UCSD-Quadcopter-Class/quad-hardware-batman/quadcopter.brd

## EAGLE design quadcopter.brd (2017-05-15)

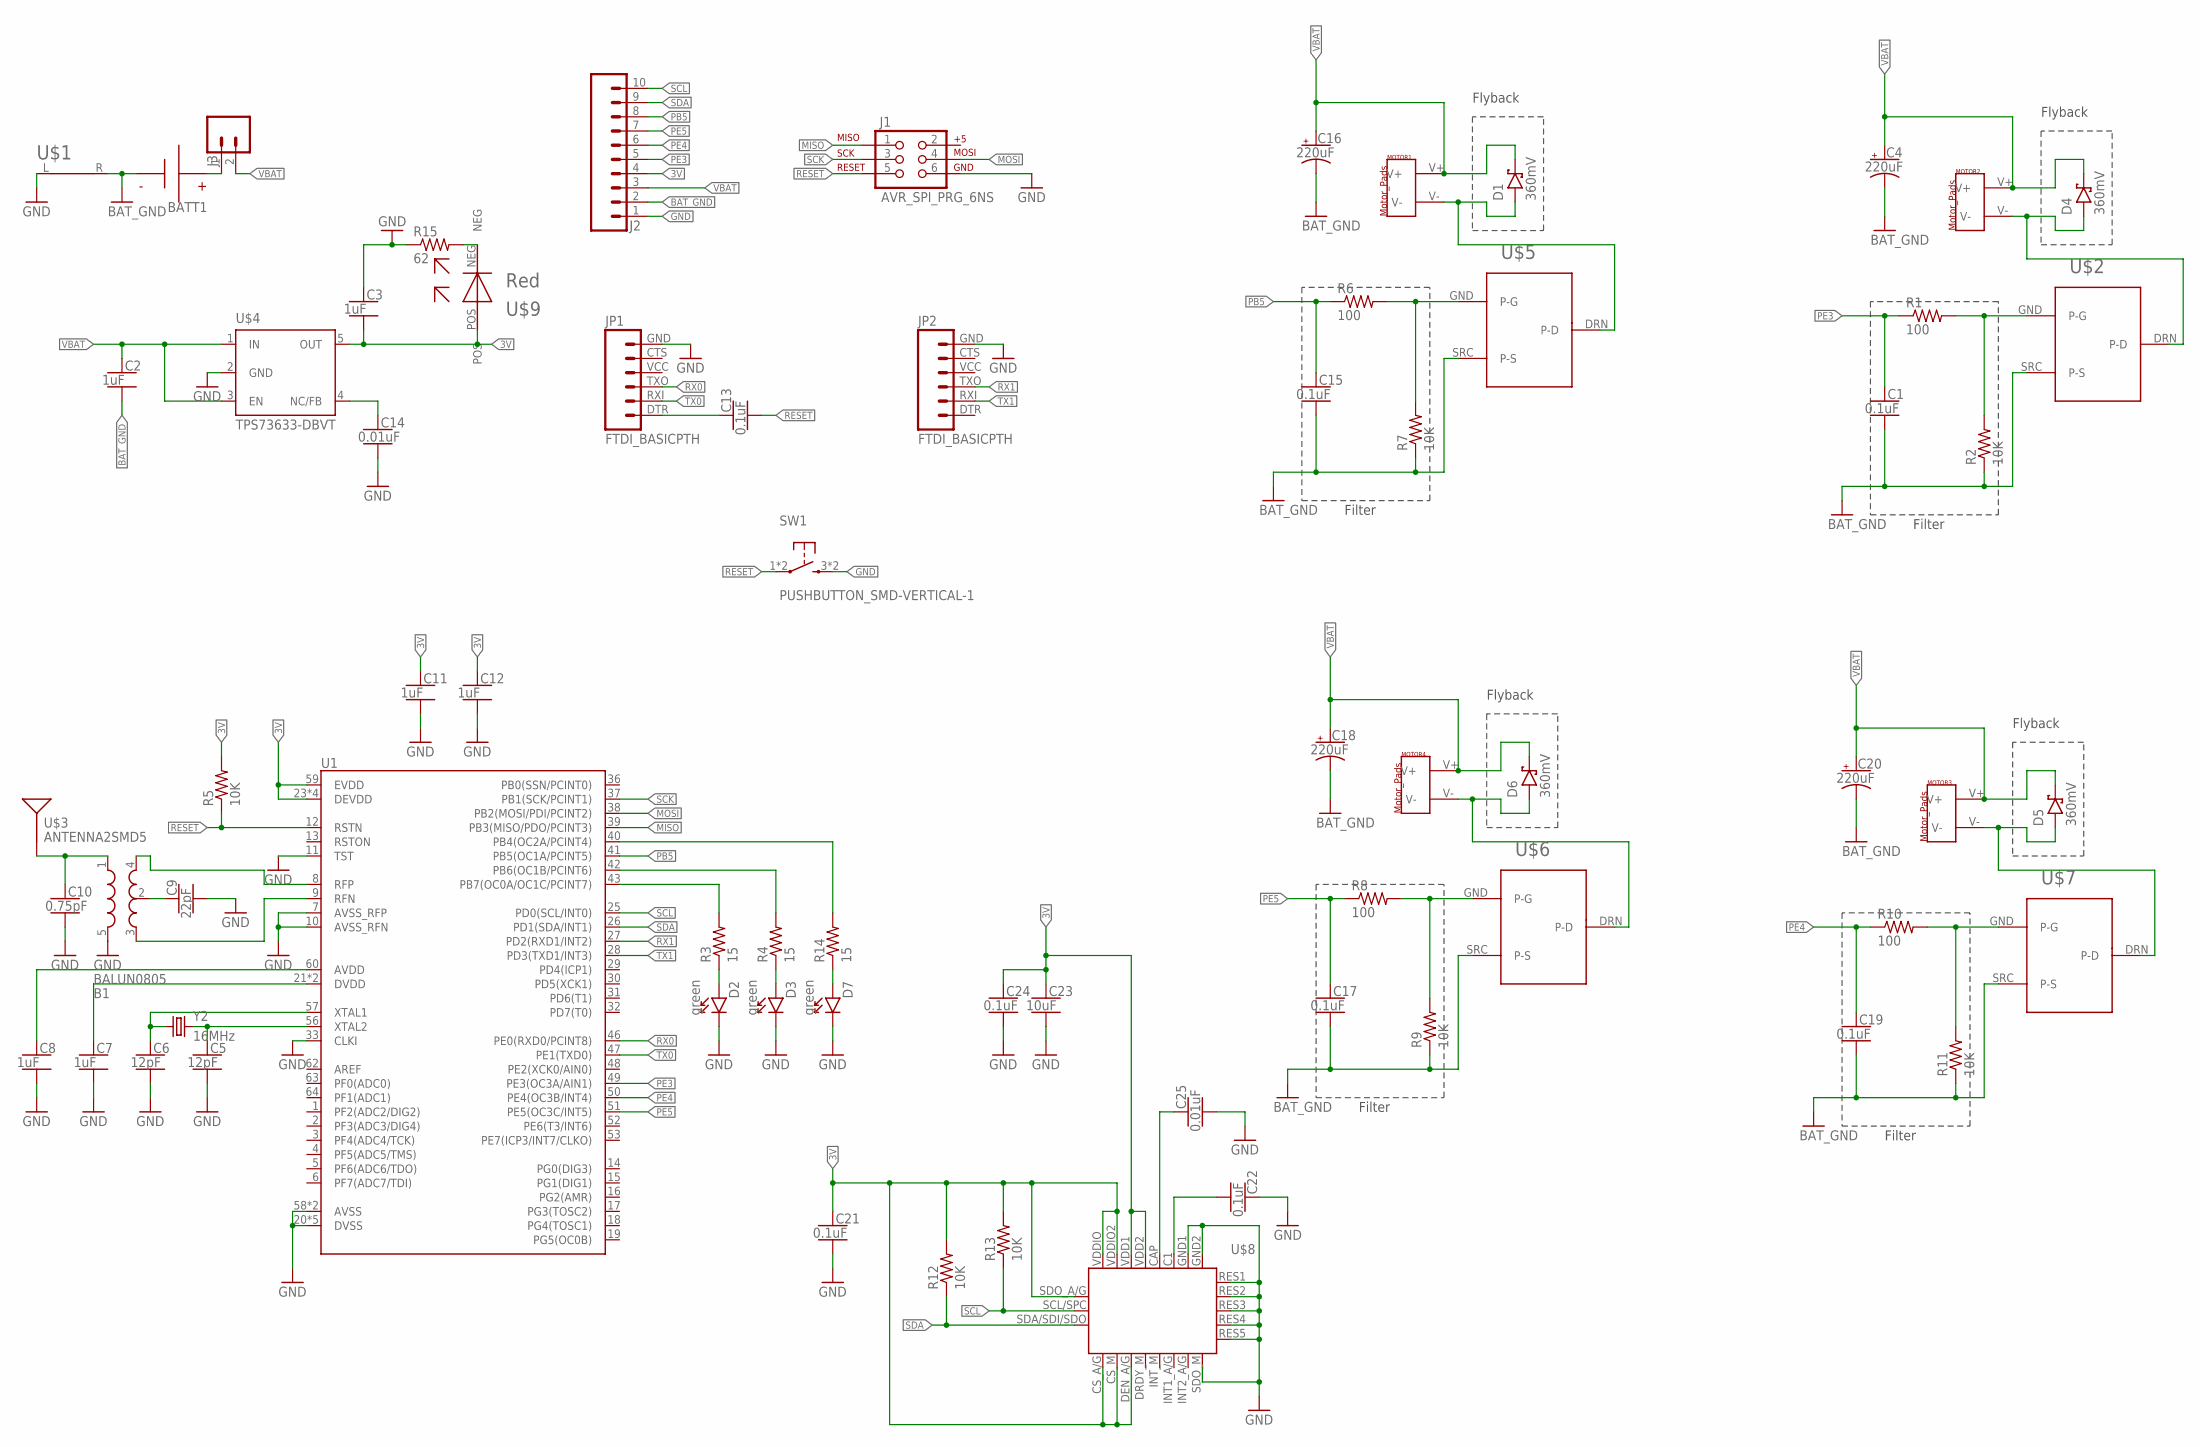
[picture p1: schematic quadcopter.sch]

Parts:
B1: BALUN0805; BALUN
BATT1: BATTERY-HUBSAN-W/HOLDER; BATTERY-W/HOLDER-380MAH-HUBSAN
C1, C13, C15, C17, C19, C21, C22, C24: 0.1uF; CAPC2012X140_HS
C2, C3, C7, C8, C11, C12: 1uF; CAPC2012X140_HS
C4, C16, C18, C20: 220uF; CAPMP7343X310_HS
C5, C6: 12pF; CAPC2012X140_HS
C9: 22pF; CAPC2012X140_HS
C10: 0.75pF; CAPC2012X140_HS
C14, C25: 0.01uF; CAPC2012X140_HS
C23: 10uF; CAPC2012X140_HS
D1, D4, D5, D6: 360mV; SOD3716X135_HS
D2, D3, D7: green; LEDSC125X200X120-2_HS
J1: AVR_SPI_PRG_6NS; 2X3-NS
J2: SIP-10_TH-254X10; HDRV10W63P254_10X1_2540X254H838_HS
J3: MALE_HEADER_2POS-2X1-0.1IN; MALE_HEADER_2X1_0.1IN
JP1, JP2: FTDI_BASICPTH; FTDI_BASIC
MOTOR1, MOTOR2, MOTOR3, MOTOR4: MOTOR_PADS
R1, R6, R8, R10: 100; RESC2012X60_HS
R2, R5, R7, R9, R11, R12, R13: 10K; RESC2012X60_HS
R3, R4, R14: 15; RESC2012X60_HS
R15: 62; RESC2012X60_HS
SW1: PUSHBUTTON_SMD-VERTICAL-1; TE_FSM8JSMA_HS
U1: ATMEGA128RFA1; QFN-64
U$1: NET_BRIDGE
U$2, U$5, U$6, U$7: MOSFET_20V
U$3: ANTENNA2SMD5; ANTENNA-CHIP5
U$4: TPS73633-DBVT; SOT23-DBV
U$8: IMU_9AXIS
U$9: Red; RED_LED_0805
Y2: 16MHz; CRYSTAL-SMD-5X3

Connections:
3V: C3.2, C11.1, C12.1, C21.1, C23.1, C24.1, J2.4, R5.2, R12.2, R13.2, U1.23 (DEVDD), U1.34 (DEVDD), U1.44 (DEVDD), U1.54 (DEVDD), U1.59 (EVDD), U$4.5 (OUT), U$8.CS_A/G, U$8.CS_M, U$8.DEN_A/G, U$8.SDO_A/G, U$8.VDD1, U$8.VDD2, U$8.VDDIO (VDDIO1), U$8.VDDIO2, U$9.POS
BAT_GND: BATT1.- (N), C1.2, C2.2, C4.2 (-), C15.2, C16.2 (-), C17.2, C18.2 (-), C19.2, C20.2 (-), J2.2, R2.1, R7.1, R9.1, R11.1, U$1.R, U$2.SRC (P-S), U$5.SRC (P-S), U$6.SRC (P-S), U$7.SRC (P-S)
FILTERED1: R6.2, R7.2, U$5.GND (P-G)
FILTERED2: R1.2, R2.2, U$2.GND (P-G)
FILTERED3: R10.2, R11.2, U$7.GND (P-G)
FILTERED4: R8.2, R9.2, U$6.GND (P-G)
FLYBACK1: D1.A, MOTOR1.V-, U$5.DRN (P-D)
FLYBACK2: D4.A, MOTOR2.V-, U$2.DRN (P-D)
FLYBACK3: D5.A, MOTOR3.V-, U$7.DRN (P-D)
FLYBACK4: D6.A, MOTOR4.V-, U$6.DRN (P-D)
GND: B1.5 (GND), C3.1, C5.2, C6.2, C7.2, C8.2, C9.2, C10.2, C11.2, C12.2, C14.2, C21.2, C22.1, C23.2, C24.2, C25.2, D2.C, D3.C, D7.C, J1.6, J2.1, JP1.GND (6), JP2.GND (6), R15.1, SW1.3 (2), SW1.4 (2), U1.7 (AVSS_RFP), U1.10 (AVSS_RFN), U1.11 (TST), U1.20 (DVSS), U1.24 (DVSS), U1.33 (CLKI), U1.35 (DVSS), U1.45 (DVSS), U1.55 (DVSS), U1.58 (AVSS), U1.61 (AVSS), U$1.L, U$4.2 (GND), U$8.GND1, U$8.GND2, U$8.RES1, U$8.RES2, U$8.RES3, U$8.RES4, U$8.RES5, U$8.SDO_M
MISO: J1.1, U1.39 (PB3(MISO/PDO/PCINT3))
MOSI: J1.4, U1.38 (PB2(MOSI/PDI/PCINT2))
unnamed: C14.1, U$4.4 (NC/FB)
unnamed: D7.A, R14.1
unnamed: D2.A, R3.1
unnamed: C5.1, U1.56 (XTAL2), Y2.3 (2)
unnamed: C6.1, U1.57 (XTAL1), Y2.1
unnamed: D3.A, R4.1
unnamed: C7.1, U1.21 (DVDD), U1.22 (DVDD)
unnamed: C8.1, U1.60 (AVDD)
unnamed: B1.4 (OUT1), U1.8 (RFP)
unnamed: B1.3 (OUT2), U1.9 (RFN)
unnamed: B1.2 (GND), C9.1
unnamed: B1.1 (IN), C10.1, U$3.FEED
unnamed: C13.1, JP1.DTR (1)
unnamed: BATT1.+, J3.1
unnamed: R15.2, U$9.NEG
unnamed: C25.1, U$8.CAP
unnamed: C22.2, U$8.C1
PB4: R14.2, U1.40 (PB4(OC2A/PCINT4))
PB5: C15.1, J2.8, R6.1, U1.41 (PB5(OC1A/PCINT5))
PB6: R4.2, U1.42 (PB6(OC1B/PCINT6))
PB7: R3.2, U1.43 (PB7(OC0A/OC1C/PCINT7))
PE3: C1.1, J2.5, R1.1, U1.49 (PE3(OC3A/AIN1))
PE4: C19.1, J2.6, R10.1, U1.50 (PE4(OC3B/INT4))
PE5: C17.1, J2.7, R8.1, U1.51 (PE5(OC3C/INT5))
RESET: C13.2, J1.5, R5.1, SW1.1, SW1.2 (1), U1.12 (RSTN)
RX0: JP1.TXO (3), U1.46 (PE0(RXD0/PCINT8))
RX1: JP2.TXO (3), U1.27 (PD2(RXD1/INT2))
SCK: J1.3, U1.37 (PB1(SCK/PCINT1))
SCL: J2.10, R13.1, U1.25 (PD0(SCL/INT0)), U$8.SCL/SPC
SDA: J2.9, R12.1, U1.26 (PD1(SDA/INT1)), U$8.SDA/SDI/SDO
TX0: JP1.RXI (2), U1.47 (PE1(TXD0))
TX1: JP2.RXI (2), U1.28 (PD3(TXD1/INT3))
VBAT: C2.1, C4.1 (+), C16.1 (+), C18.1 (+), C20.1 (+), D1.C, D4.C, D5.C, D6.C, J2.3, J3.2, MOTOR1.V+, MOTOR2.V+, MOTOR3.V+, MOTOR4.V+, U$4.1 (IN), U$4.3 (EN)

Notes on the sheet:
Flyback
Filter

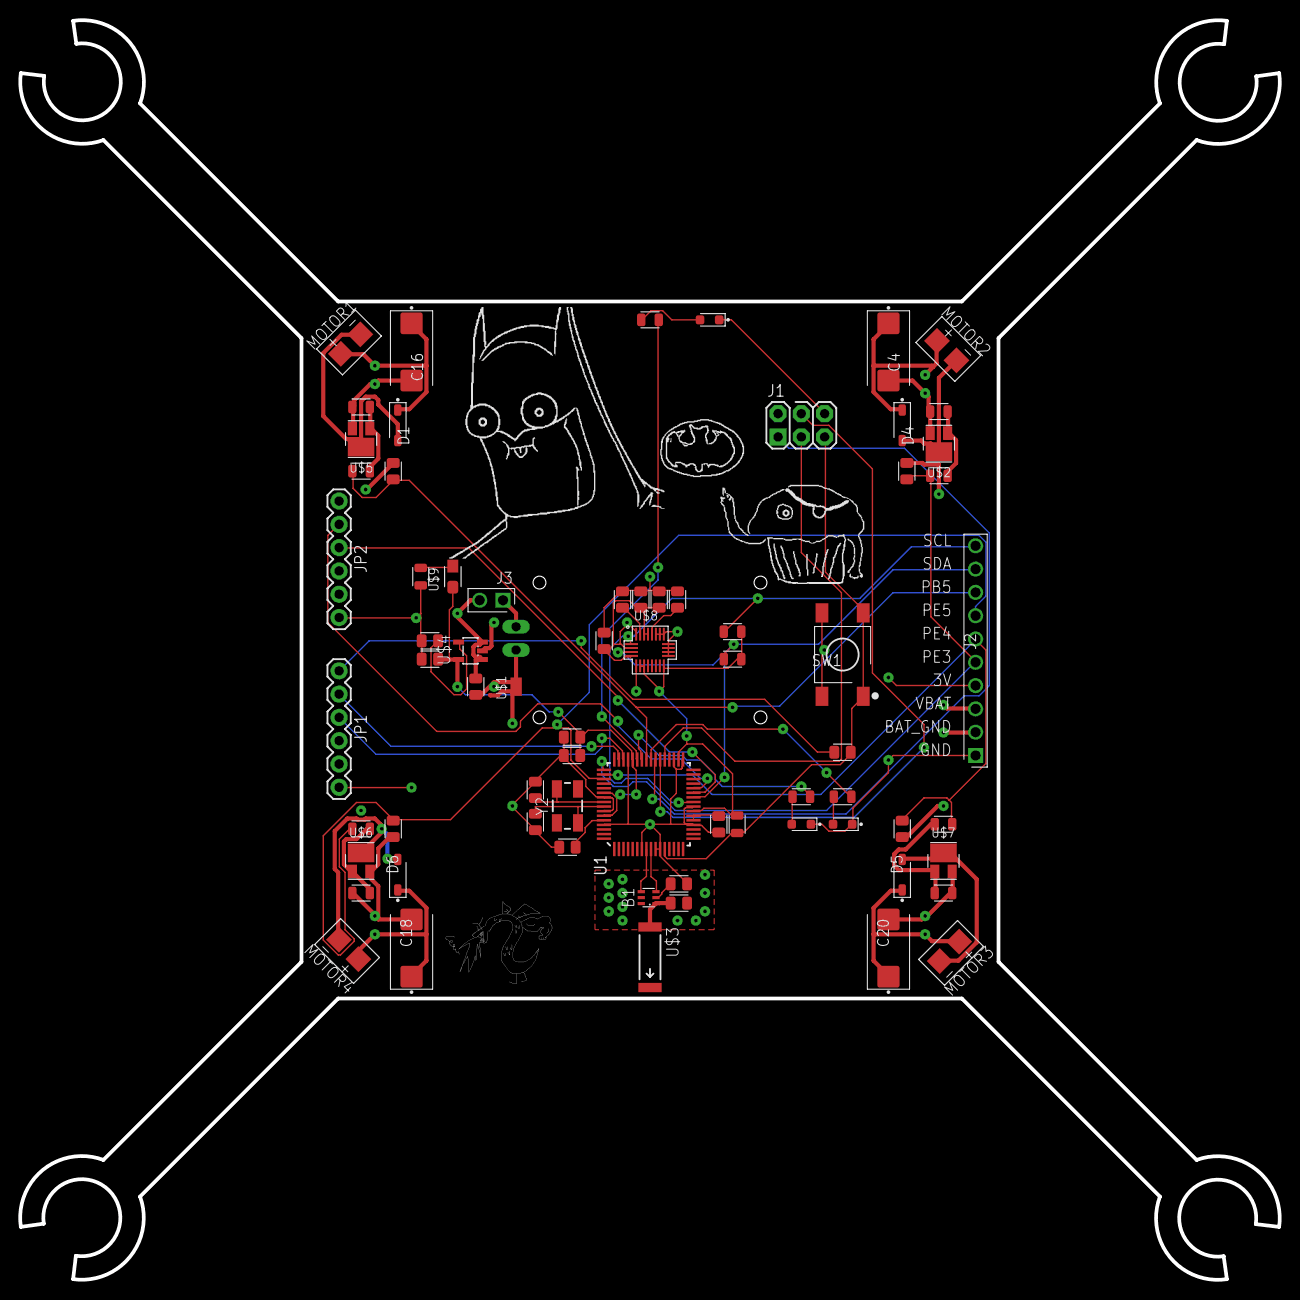
[picture p2: board quadcopter.brd from above]

Board: 4 copper layers, 137.3 x 137.3 mm, 73 parts (1 on the bottom side), 46 nets.

Other parts of the board:
U$10: DERPY_BATMAN
U$11: MUFFIN_MAN
U$12: TROGDOR
