UCSD-Quadcopter-Class/quad-hardware-batman/(commit log)

2017-04-18 adding starter files
    [PartList.xlsx, quadcopter.sch]
2017-04-18 Added voltage regulator doc
2017-04-18 didn't actually make changes to quadcopter.sch, but added the rough schematic of the motor with the updated parts
    [our_motor_driver.sch, quadcopter.sch]
2017-04-18 Beginning to copy red board design
    [quadcopter.sch]
2017-04-18 added IMU.sch and made an edit to the IMU device in quadparts.lbr
    [IMU.sch, our_motor_driver.sch]
2017-04-18 Added necessary components from red board design
    [quadcopter.sch]
2017-04-18 Added power supply, FTDI and debugging headers, misc. fixes.
    [quadcopter.sch]
2017-04-19 Added battery disconnect, replicated motor controller w/ pwm, misc fixes.
    [quadcopter.sch]
2017-04-19 added IMU to quadcopter
    [IMU.sch, quadcopter.sch]
2017-04-19 pinned up IMU
    [quadcopter.sch]
2017-04-20 pushing who am i and final changes to the IMU
    [quadcopter.sch]
2017-04-20 removing IMU schematic file
    [IMU.sch]
2017-04-20 adding red led device
2017-04-20 Small fixes for IMU, added PID to who_am_i
    [quadcopter.sch]
2017-04-20 added tag and datasheet for our led
2017-04-20 Added LEDs, correct resistors, and replaced some devices with correct variants.
    [quadcopter.sch]
2017-04-20 final commits for Lab 4
    [quadcopter.sch]
2017-04-20 now, this is really the last commit because there was more to add and now there isn't
    [quadcopter.sch]
2017-04-25 Added review notes and reviewer attribute to devices
    [quadcopter.sch]
2017-04-25 Fixed small issues found from design review
    [quadcopter.sch]
2017-04-26 Fixed some issues found from review, notably IMU pins
2017-04-27 git after the local repo reset contains quadparts.sch/brd, the new dru, and the modified quadparts.lbr
    [quadcopter.brd, quadcopter.sch]
2017-04-27 instructior review of original schematic
2017-04-28 AO: adding redesigned board with X configuration
    [quadcopter.brd, quadcopter.sch]
2017-04-29 added the ground and power planes to the board as well as the Ground Shield/Faraday cage to the antenna but may need review
    [quadcopter.brd]
2017-04-30 Fixed small issues in schematic, worked on board layout (antenna and pour connections mostly)
    [quadcopter.brd, quadcopter.sch]
2017-05-01 Board optimizations, focusing on IMU and making space for the autorouter.
    [quadcopter.brd, quadcopter.sch]
2017-05-02 Optimized clock and antenna placement, fixed net bridge, misc. optimizations.
    [quadcopter.brd, quadcopter.sch]
2017-05-02 Board fully routed
    [quadcopter.brd]
2017-05-04 Added board design review docs
2017-05-04 Removed filter/flyback labels in schematic, refined placement of many board components
    [quadcopter.brd, quadcopter.sch]
2017-05-05 Fixed motor holder and arm dimensions (now fits within bounding box
    [quadcopter.brd]
2017-05-06 Manually routed crystal, minor optimizations
    [quadcopter.brd]
2017-05-06 Routed board
    [quadcopter.brd]
2017-05-08 Repositioned battery holder and voltage regulator
    [quadcopter.brd]
2017-05-09 Minor tweaks, added CAM folder
    [quadcopter.brd]
2017-05-09 Ready to be routed
    [quadcopter.brd]
2017-05-09 Routed board with CAM files
    [quadcopter.brd]
2017-05-11 commiting new CAM files and new board logos
    [quadcopter.brd]
2017-05-11 Board ready to be routed with new DRU file
    [quadcopter.brd]
2017-05-11 new cam files and rerouted board and stuff
    [quadcopter.brd]
2017-05-11 Ripped up everything, manually placed some vias, ready to be routed
    [quadcopter.brd]
2017-05-11 Changed antenna vias, added routes from balun
    [quadcopter.brd]
2017-05-11 Manually routed crystal, fixed motor driver filters.
    [quadcopter.brd, quadcopter.sch]
2017-05-11 Routed board, CAM files
    [quadcopter.brd]
2017-05-13 Fixed issues found by Swanson's review, board ready to be auto-routed
    [quadcopter.brd, quadcopter.sch]
2017-05-14 More schematic comments from swanson
2017-05-14 Fixed additional issues found by Swanson in schematic
    [quadcopter.brd, quadcopter.sch]
2017-05-14 Auto-routed board
    [quadcopter.brd]
2017-05-15 Fixed small airwire
    [quadcopter.brd]
